rambros3d/MicroSpora-SimpleFOC/README.md

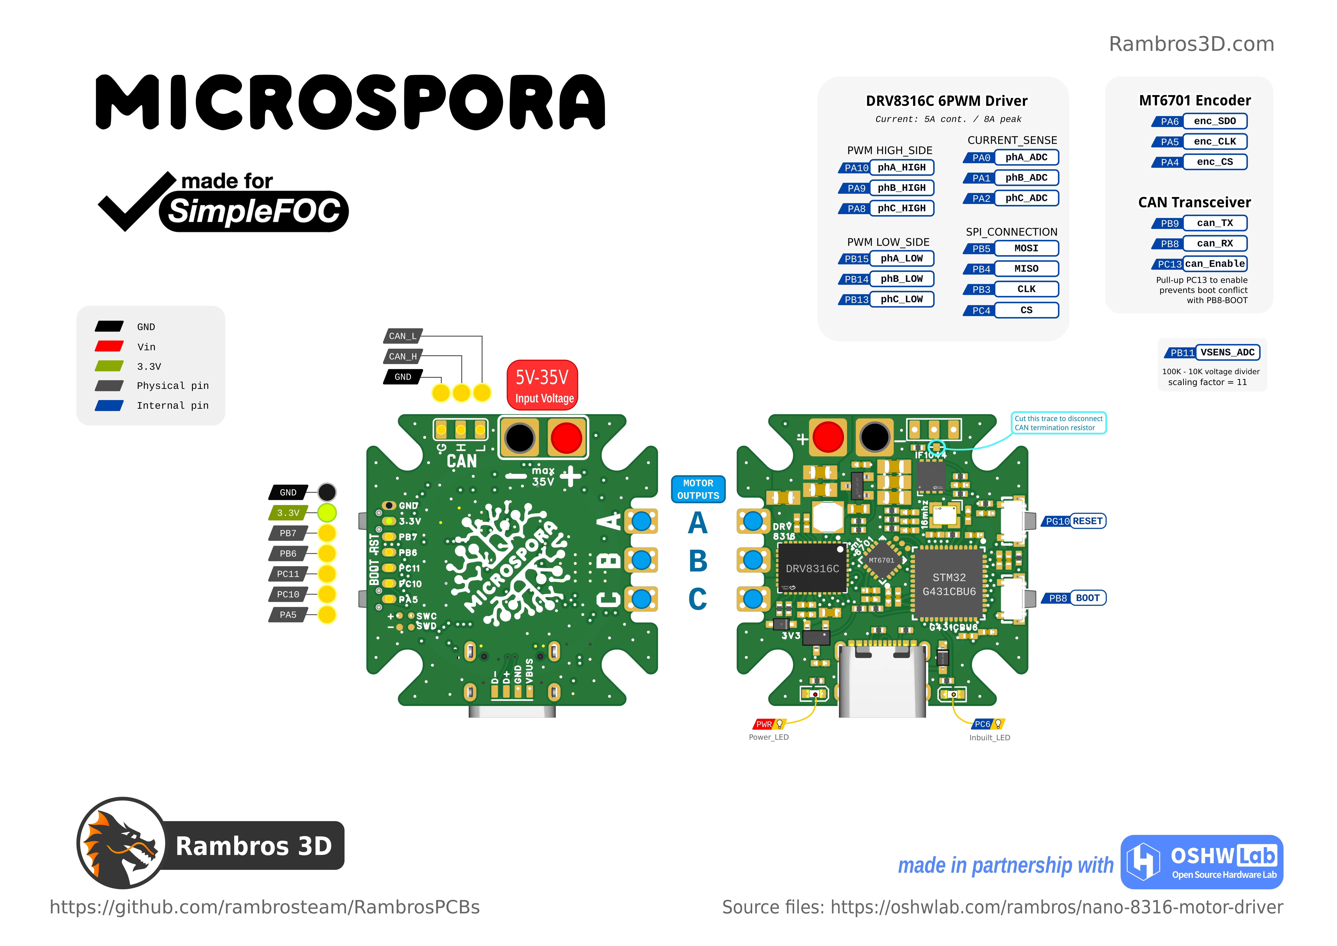
[picture p1: Microspora-pinout-rambros3d.webp]
Pinout
