rambros3d/MicroSpora-SimpleFOC/photos/eda-renders/3D_MicroSpora_Board_top.png

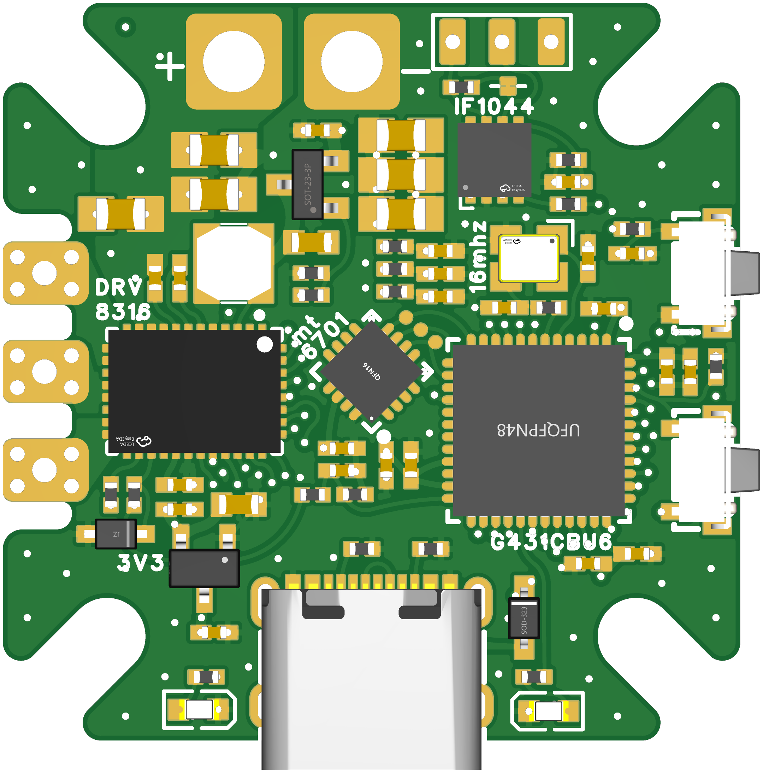
photos/eda-renders/3D_MicroSpora_Board_top.png
