rambros3d/MicroSpora-SimpleFOC/photos/MicroSpora-photo-A2212-bottom.jpg

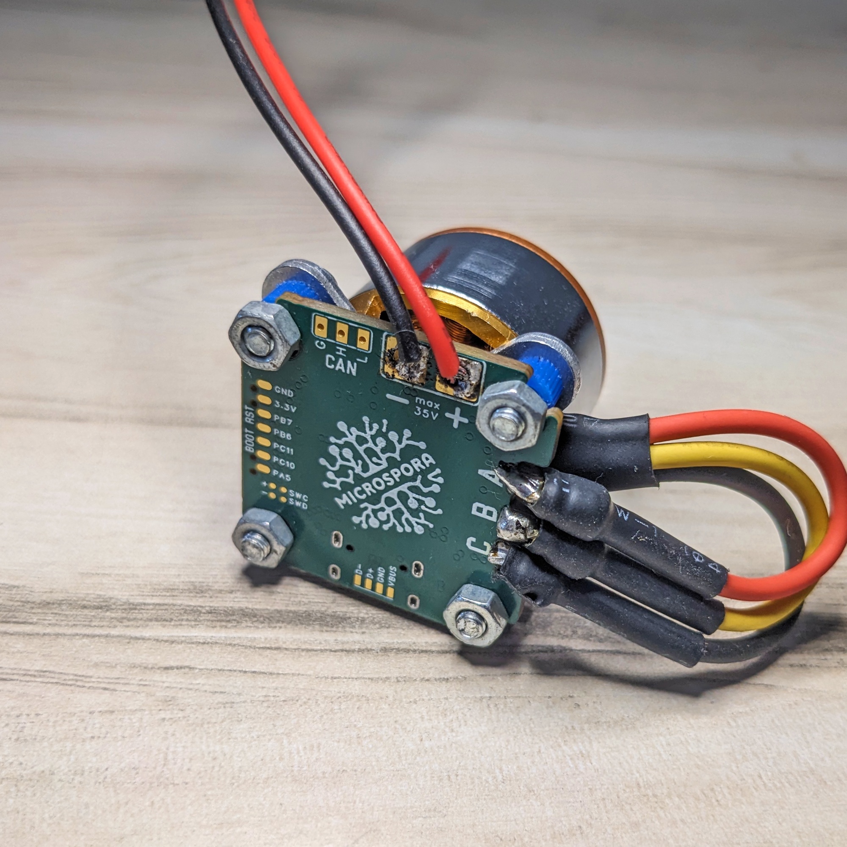
photos/MicroSpora-photo-A2212-bottom.jpg
