rambros3d/MicroSpora-SimpleFOC/photos/MicroSpora-photo-A2212-pers.jpg

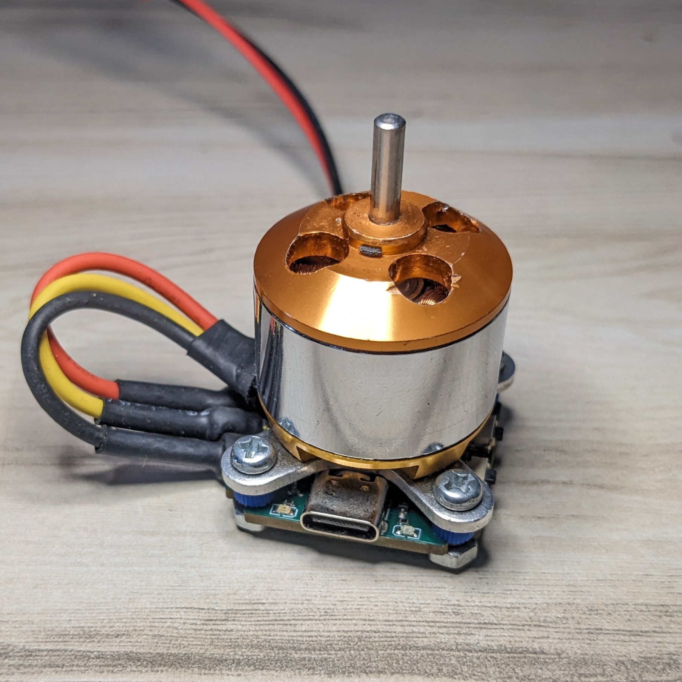
photos/MicroSpora-photo-A2212-pers.jpg
