rambros3d/MicroSpora-SimpleFOC/photos/MicroSpora-photo-A2212-side.jpg

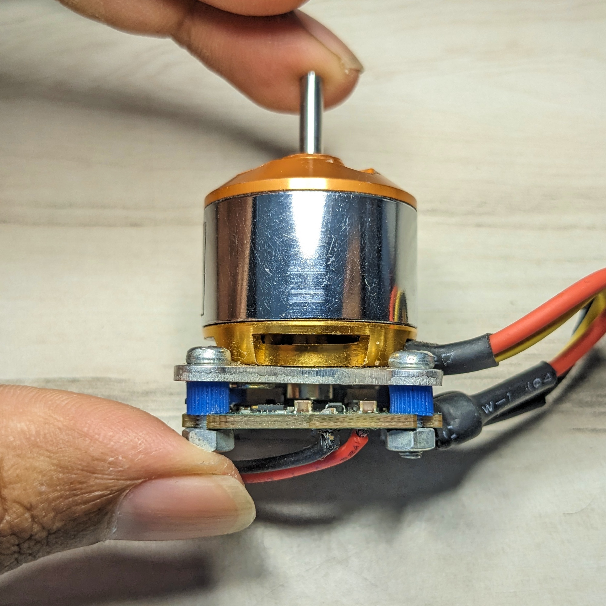
photos/MicroSpora-photo-A2212-side.jpg
