rambros3d/MicroSpora-SimpleFOC/photos/MicroSpora-photo-bottom.jpg

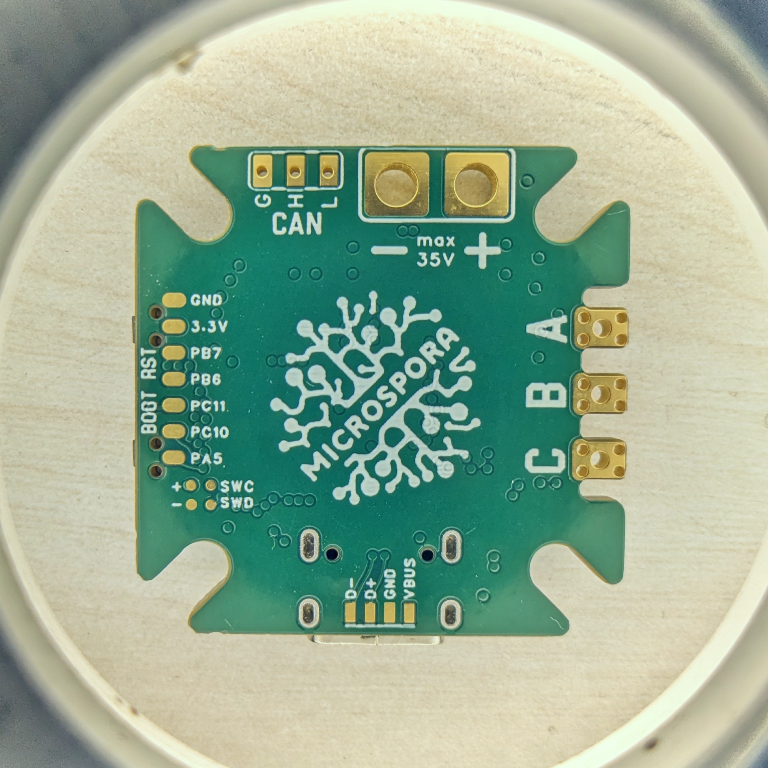
photos/MicroSpora-photo-bottom.jpg
