rambros3d/MicroSpora-SimpleFOC/photos/MicroSpora-photo-cover.jpg

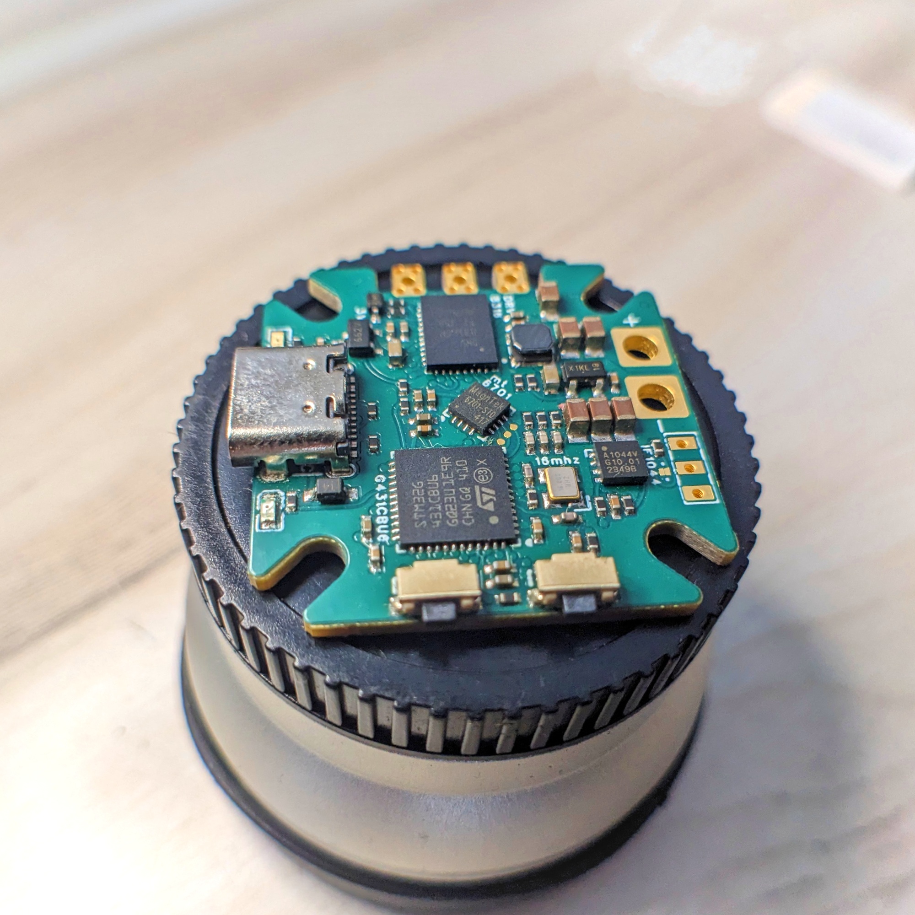
photos/MicroSpora-photo-cover.jpg
