rambros3d/MicroSpora-SimpleFOC/photos/MicroSpora-photo-top.jpg

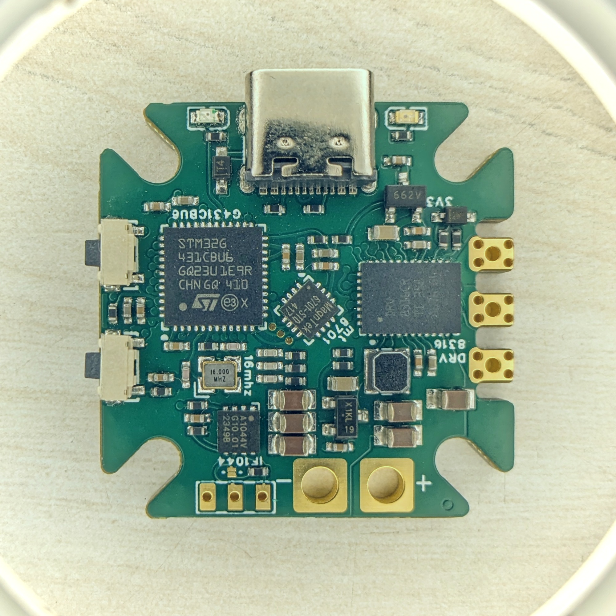
photos/MicroSpora-photo-top.jpg
