rambros3d/MicroSpora-SimpleFOC/magnet_aligner.stl

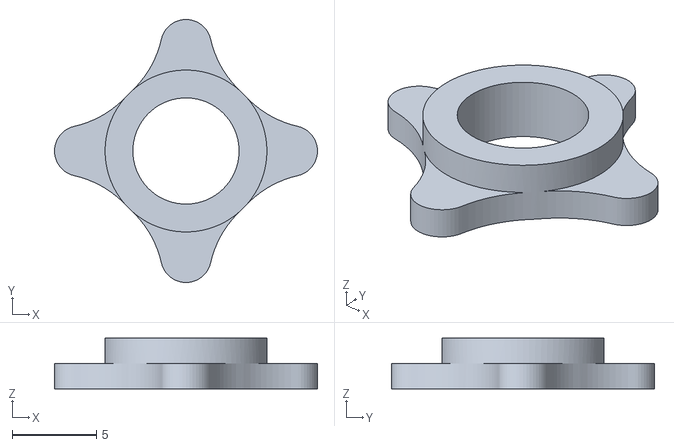
[picture p12: CAD file, 2024-10-22]
magnet_aligner.stl
15.6 x 15.6 x 3.00
