rambros3d/MicroSpora-SimpleFOC/hardware/SCH_MicroSpora_Schematic_2024.pdf

# GPIO Led

# Power Led

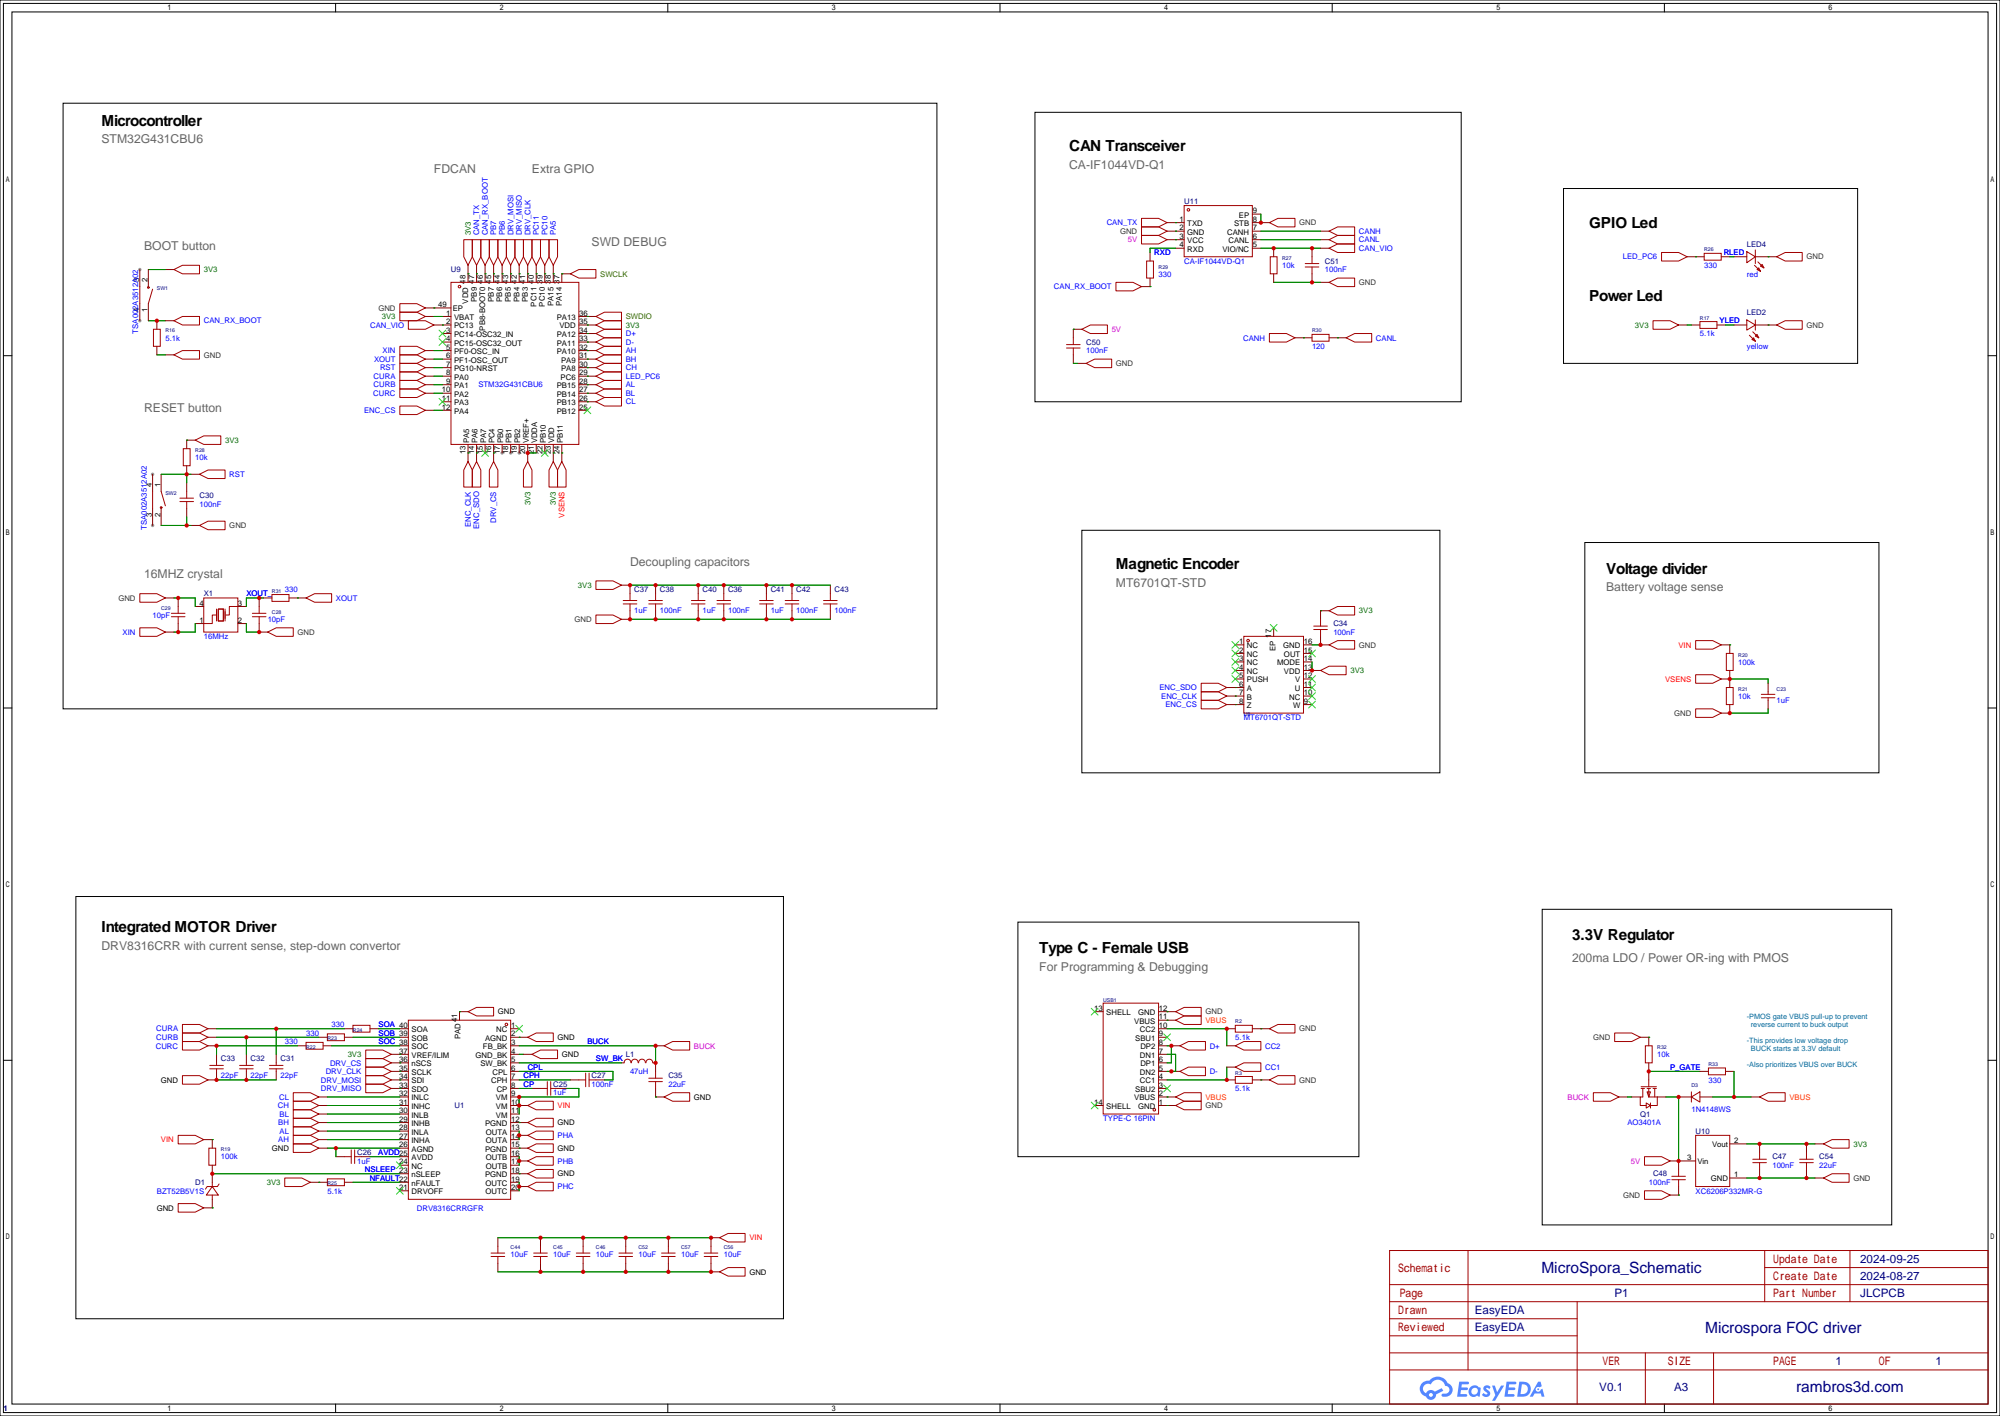
[picture p13: page 1]

PB12 25 PB¹¹ 24 VDD 23 PB¹⁰ 22 VDDA 21 VREF+ 20 PB² 19 PB¹ 18 PB⁰ 17 PC⁴ 16 PA⁷ 15 PA⁶ 14 PA⁵ 13

Integrated MOTOR Driver
DRV8316CRR with current sense, step-down convertor

3.3V Regulator
200ma LDO / Power OR-ing with PMOS

-PMOS gate VBUS pull-up to prevent
reverse current to buck output
-This provides low voltage drop
BUCK starts at 3.3V default
-Also prioritizes VBUS over BUCK
