rambros3d/MicroSpora-SimpleFOC/(commit log)

2024-10-08 fix driver SPI
2024-10-11 correct input voltage
2024-10-11 add arduino compatibility
2024-10-11 fix input voltage
2024-10-11 added schematic
2024-10-13 sensor offset and direction example
